dinhnd-hust/Octopus/v241218_Octopus_VerA1.kicad_pcb

## KiCad design v241218_Octopus_VerA1.kicad_pcb (2025-03-01)

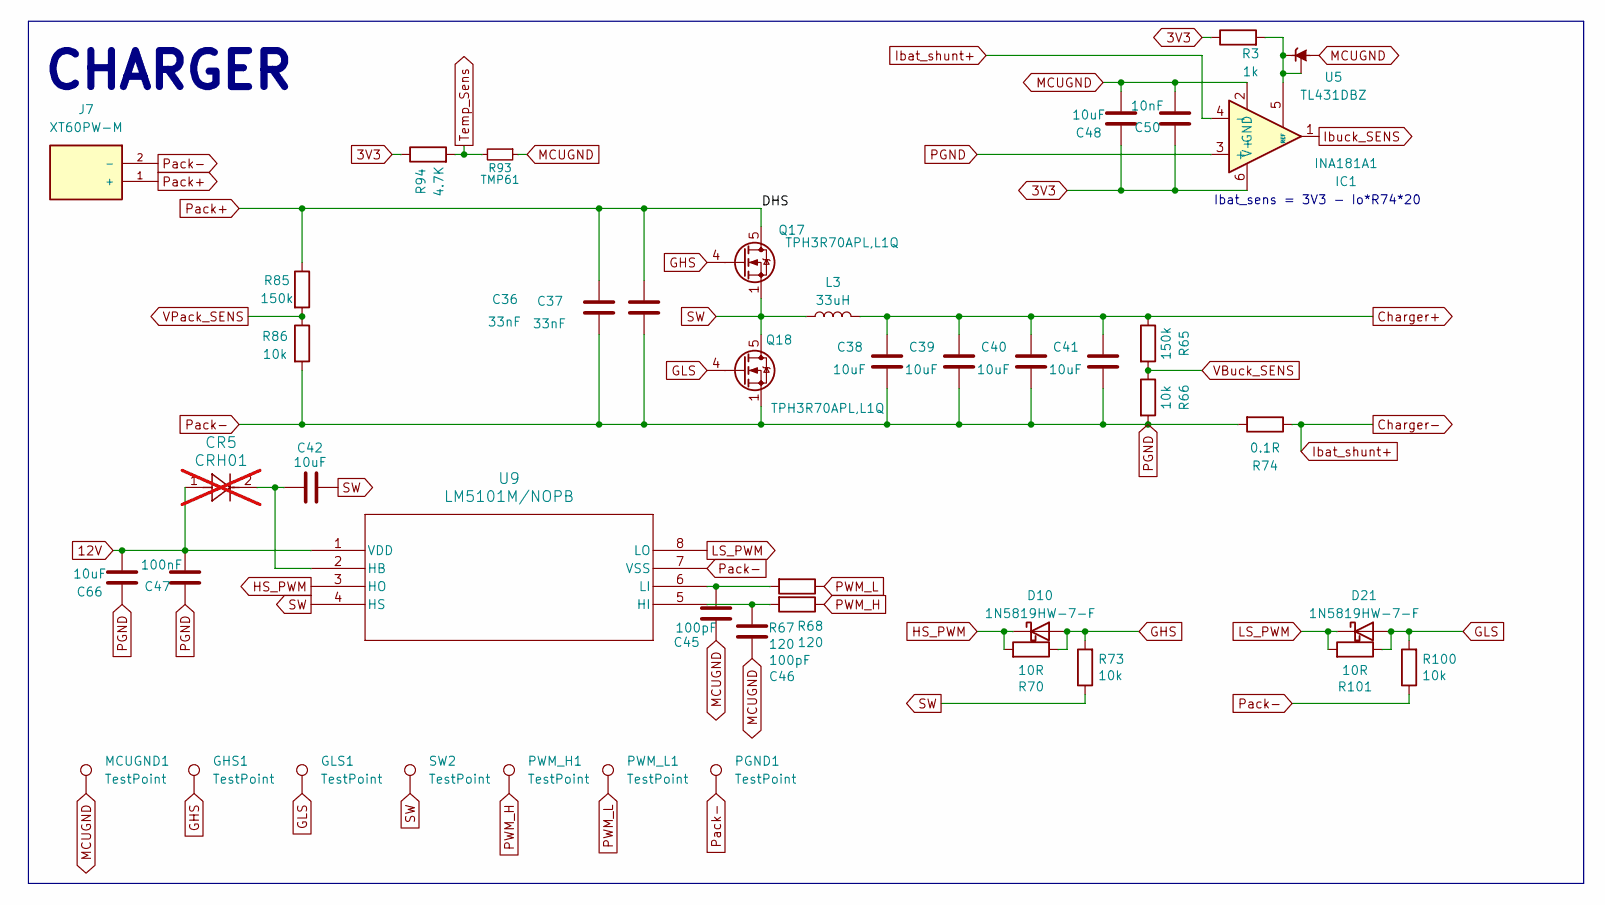
[picture p1: schematic Boost_Buck_Charger.kicad_sch]

Parts:
C36, C37: 33nF; C_1206_3216Metric; Mfr. # C1206B104K500NT
C38, C39, C40, C41, C42: 10uF; C_1206_3216Metric; Mfr. # C1206B104K500NT
C45, C46: 100pF; C_0603_1608Metric; Part Number KGQ15ACG1H101JT
C47: 100nF; C_0603_1608Metric; Part Number C0603C104M4RAC
C48, C66: 10uF; C_0603_1608Metric; Mfr. # MCF05KTX160106
C50: 10nF; C_0603_1608Metric; Part Number KAM15AR71H103MT
CR5: CRH01; S-FLAT_TOS; Part Number CRH01(TE85L,Q,M); not fitted
D10, D21: 1N5819HW-7-F; D_SOD-123; Part Number 1N5819HW-7-F
GHS1: TestPoint; TestPoint_Pad_D1.5mm
GLS1: TestPoint; TestPoint_Pad_D1.5mm
IC1: INA181A1; SOT-23-6; Mfr. # INA181A1IDBVR
J7: XT60PW-M; AMASS_XT60PW-M; PARTREV V1.2
L3: 33uH; L_Sunlord_MWSA1204S-2R2; Part Number SRR1280-330M
MCUGND1: TestPoint; TestPoint_Pad_D1.5mm
PGND1: TestPoint; TestPoint_Pad_D1.5mm
PWM_H1: TestPoint; TestPoint_Pad_D1.5mm
PWM_L1: TestPoint; TestPoint_Pad_D1.5mm
Q17, Q18: TPH3R70APL,L1Q; AO_DFN-8-1EP_5.55x5.2mm_P1.27mm_EP4.12x4.6mm; Part Number TPH3R70APL,L1Q
R3: 1k; R_0603_1608Metric; Mfr. # CR0805-FX-1003ELF
R65: 150k; R_0805_2012Metric; Mfr. # CR0805-FX-1003ELF
R66, R86: 10k; R_0805_2012Metric; Mfr. # CR0805-FX-1003ELF
R67, R68: 120; R_0603_1608Metric; Mfr. # CR0603-FX-1002ELF
R70, R101: 10R; R_0603_1608Metric; Part Number RS-05F10R0FT
R73, R100: 10k; R_0603_1608Metric; Part Number RS-03K1002FT
R74: 0.1R; R_2512_6332Metric; Part Number LR122WF100LT4E
R85: 150k; R_0805_2012Metric; Mfr. # CR0805-FX-1503ELF
R93: TMP61; R_0603_1608Metric; Mouser Part Number 595-TMP6131DECR
R94: 4.7K; R_0603_1608Metric; Mfr. # CR0805-FX-1003ELF
SW2: TestPoint; TestPoint_Pad_D1.5mm
U5: TL431DBZ; SOT-23; Part Number TL431BIDBZR
U9: LM5101M/NOPB; M08A; Part Number LM5101AM/NOPB

Connections:
3V3: C48.2, C50.2, IC1.6 (V+), R3.1, R94.1; also elsewhere on the board
12V: C47.1, C66.1, CR5.1, U9.1 (VDD); also elsewhere on the board
Charger+: C38.2, C39.2, C40.2, C41.2, L3.2, R65.1; also elsewhere on the board
Charger-: IC1.4 (-), R74.1; also elsewhere on the board
GHS: D10.2 (A), GHS1.1, Q17.4 (G), R70.1, R73.2
GLS: D21.2 (A), GLS1.1, Q18.4 (G), R100.2, R101.1
HS_PWM: D10.1 (K), R70.2, U9.3 (HO)
Ibuck_SENS: IC1.1; also elsewhere on the board
LS_PWM: D21.1 (K), R101.2, U9.8 (LO)
MCUGND: C45.2, C46.2, C48.1, C50.1, IC1.2 (GND), MCUGND1.1, R93.1, U5.3 (A); also elsewhere on the board
unnamed: IC1.5 (REF), R3.2, U5.1 (K), U5.2 (REF)
unnamed: C42.2, CR5.2, U9.2 (HB)
unnamed: C46.1, R68.2, U9.5 (HI)
unnamed: C45.1, R67.2, U9.6 (LI)
PGND: C36.1, C37.1, C38.1, C39.1, C40.1, C41.1, C47.2, C66.2, IC1.3 (+), J7.2 (-), PGND1.1, Q18.1 (S), Q18.2 (S), Q18.3 (S), R66.2, R74.2, R86.2, R100.1, U9.7 (VSS); also elsewhere on the board
PWM_H: PWM_H1.1, R68.1; also elsewhere on the board
PWM_L: PWM_L1.1, R67.1; also elsewhere on the board
Pack+: C36.2, C37.2, J7.1 (+), Q17.5 (D), R85.1; also elsewhere on the board
SW: C42.1, L3.1, Q17.1 (S), Q17.2 (S), Q17.3 (S), Q18.5 (D), R73.1, SW2.1, U9.4 (HS)
Temp_Sens: R93.2, R94.2; also elsewhere on the board
VBuck_SENS: R65.2, R66.1; also elsewhere on the board
VPack_SENS: R85.2, R86.1; also elsewhere on the board

Notes on the sheet:
Ibat_sens = 3V3 - Io*R74*20
CHARGER

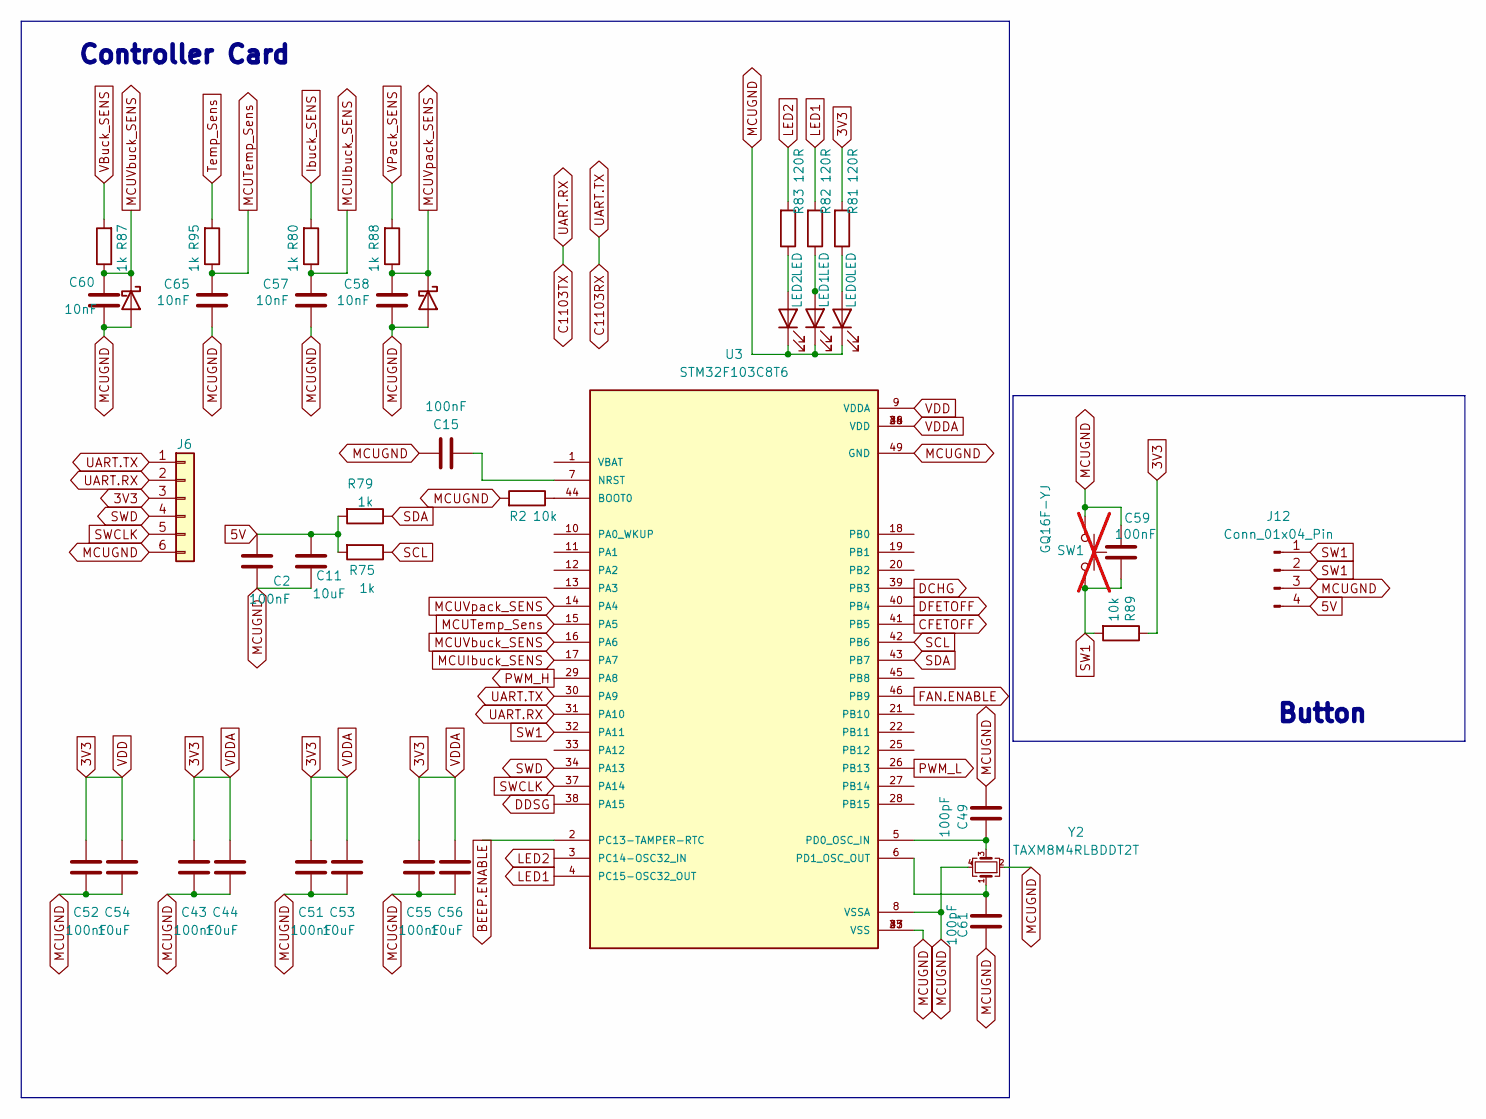
[picture p2: schematic MCU.kicad_sch]

Parts:
C2: 100nF; C_0603_1608Metric; Mfr. # MCF05KTX160106
C11: 10uF; C_0603_1608Metric; Mfr. # C2012B104K500NT
C15, C43, C51, C52, C55, C59: 100nF; C_0603_1608Metric; Mfr. # C2012B104K500NT
C44, C53, C54, C56: 10uF; C_0603_1608Metric; Mfr. # MCF05KTX160106
C49, C61: 100pF; C_0603_1608Metric; Mfr. # C2012B104K500NT
C57, C58, C65: 10nF; C_0603_1608Metric; Mfr. # C2012N102J100NT
C60: 10nF; C_0603_1608Metric; Mfr. # C2012N103J100NT
D3, D7: 1N4148; D_SOD-123; Mfr. # 1N4148W
J6: Conn_01x06; Molex_KK-254_AE-6410-06A_1x06_P2.54mm_Vertical; Part Number 22272061
J12: Conn_01x04_Pin; Molex_KK-254_AE-6410-04A_1x04_P2.54mm_Vertical; Part Number 22272041
LED0: LED; LED_0603_1608Metric; Mfr. # Red LED
LED1, LED2: LED; LED_0603_1608Metric; Mfr. # Green LED
R2: 10k; R_0603_1608Metric; Mfr. # CR0805-FX-1001ELF
R75, R79: 1k; R_0603_1608Metric; Mfr. # CR0603-FX-1002ELF
R80, R87, R88, R95: 1k; R_0603_1608Metric; Mfr. # CR0805-FX-1001ELF
R81, R82, R83: 120R; R_0603_1608Metric; Mfr. # CR0805-FX-120R0ELF
R89: 10k; R_0603_1608Metric; Mfr. # CR0603-FX-1002ELF
SW1: GQ16F-YJ; SW_PUSH_6mm; Part Number GQ16F-YJ; not fitted
U3: STM32F103C8T6; LQFP-48-1EP_7x7mm_P0.5mm_EP3.6x3.6mm_ThermalVias; PARTREV 10
Y2: TAXM8M4RLBDDT2T; Crystal_SMD_3225-4Pin_3.2x2.5mm; Part Number TAXM8M4RLBDDT2T

Connections:
3V3: C43.2, C44.1, C51.2, C52.2, C53.1, C54.1, C55.2, C56.1, J6.3, R81.2, R89.1, U3.9 (VDDA), U3.24 (VDD), U3.36 (VDD), U3.48 (VDD); also elsewhere on the board
5V: C2.1, C11.2, J12.4, R75.2, R79.2; also elsewhere on the board
BEEP.ENABLE: U3.2 (PC13-TAMPER-RTC); also elsewhere on the board
C1103RX: J6.1, U3.30 (PA9); also elsewhere on the board
C1103TX: J6.2, U3.31 (PA10); also elsewhere on the board
CFETOFF: U3.41 (PB5); also elsewhere on the board
DCHG: U3.39 (PB3); also elsewhere on the board
DDSG: U3.38 (PA15); also elsewhere on the board
DFETOFF: U3.40 (PB4); also elsewhere on the board
FAN.ENABLE: U3.46 (PB9); also elsewhere on the board
Ibuck_SENS: R80.2; also elsewhere on the board
LED1: R82.2, U3.4 (PC15-OSC32_OUT)
LED2: R83.2, U3.3 (PC14-OSC32_IN)
MCUGND: C2.2, C11.1, C15.1, C43.1, C44.2, C49.2, C51.1, C52.1, C53.2, C54.2, C55.1, C56.2, C57.1, C58.1, C59.2, C60.1, C61.1, C65.1, D3.2 (A), D7.2 (A), J6.6, J12.3, LED0.1 (K), LED1.1 (K), LED2.1 (K), R2.2, SW1.1, U3.8 (VSSA), U3.23 (VSS), U3.35 (VSS), U3.47 (VSS), U3.49 (GND), Y2.2, Y2.4; also elsewhere on the board
MCUIbuck_SENS: C57.2, R80.1, U3.17 (PA7)
MCUTemp_Sens: C65.2, R95.1, U3.15 (PA5)
MCUVbuck_SENS: C60.2, D7.1 (K), R87.1, U3.16 (PA6)
MCUVpack_SENS: C58.2, D3.1 (K), R88.1, U3.14 (PA4)
unnamed: LED0.2 (A), R81.1
unnamed: LED1.2 (A), R82.1
unnamed: LED2.2 (A), R83.1
unnamed: R2.1, U3.44 (BOOT0)
unnamed: C15.2, U3.7 (NRST)
unnamed: C49.1, U3.5 (PD0_OSC_IN), Y2.3
unnamed: C61.2, U3.6 (PD1_OSC_OUT), Y2.1
PWM_H: U3.29 (PA8); also elsewhere on the board
PWM_L: U3.26 (PB13); also elsewhere on the board
SCL: R75.1, U3.42 (PB6); also elsewhere on the board
SDA: R79.1, U3.43 (PB7); also elsewhere on the board
SW1: C59.1, J12.1, J12.2, R89.2, SW1.2, U3.32 (PA11)
SWCLK: J6.5, U3.37 (PA14)
SWD: J6.4, U3.34 (PA13)
Temp_Sens: R95.2; also elsewhere on the board
VBuck_SENS: R87.2; also elsewhere on the board
VPack_SENS: R88.2; also elsewhere on the board

Notes on the sheet:
Button
Controller Card

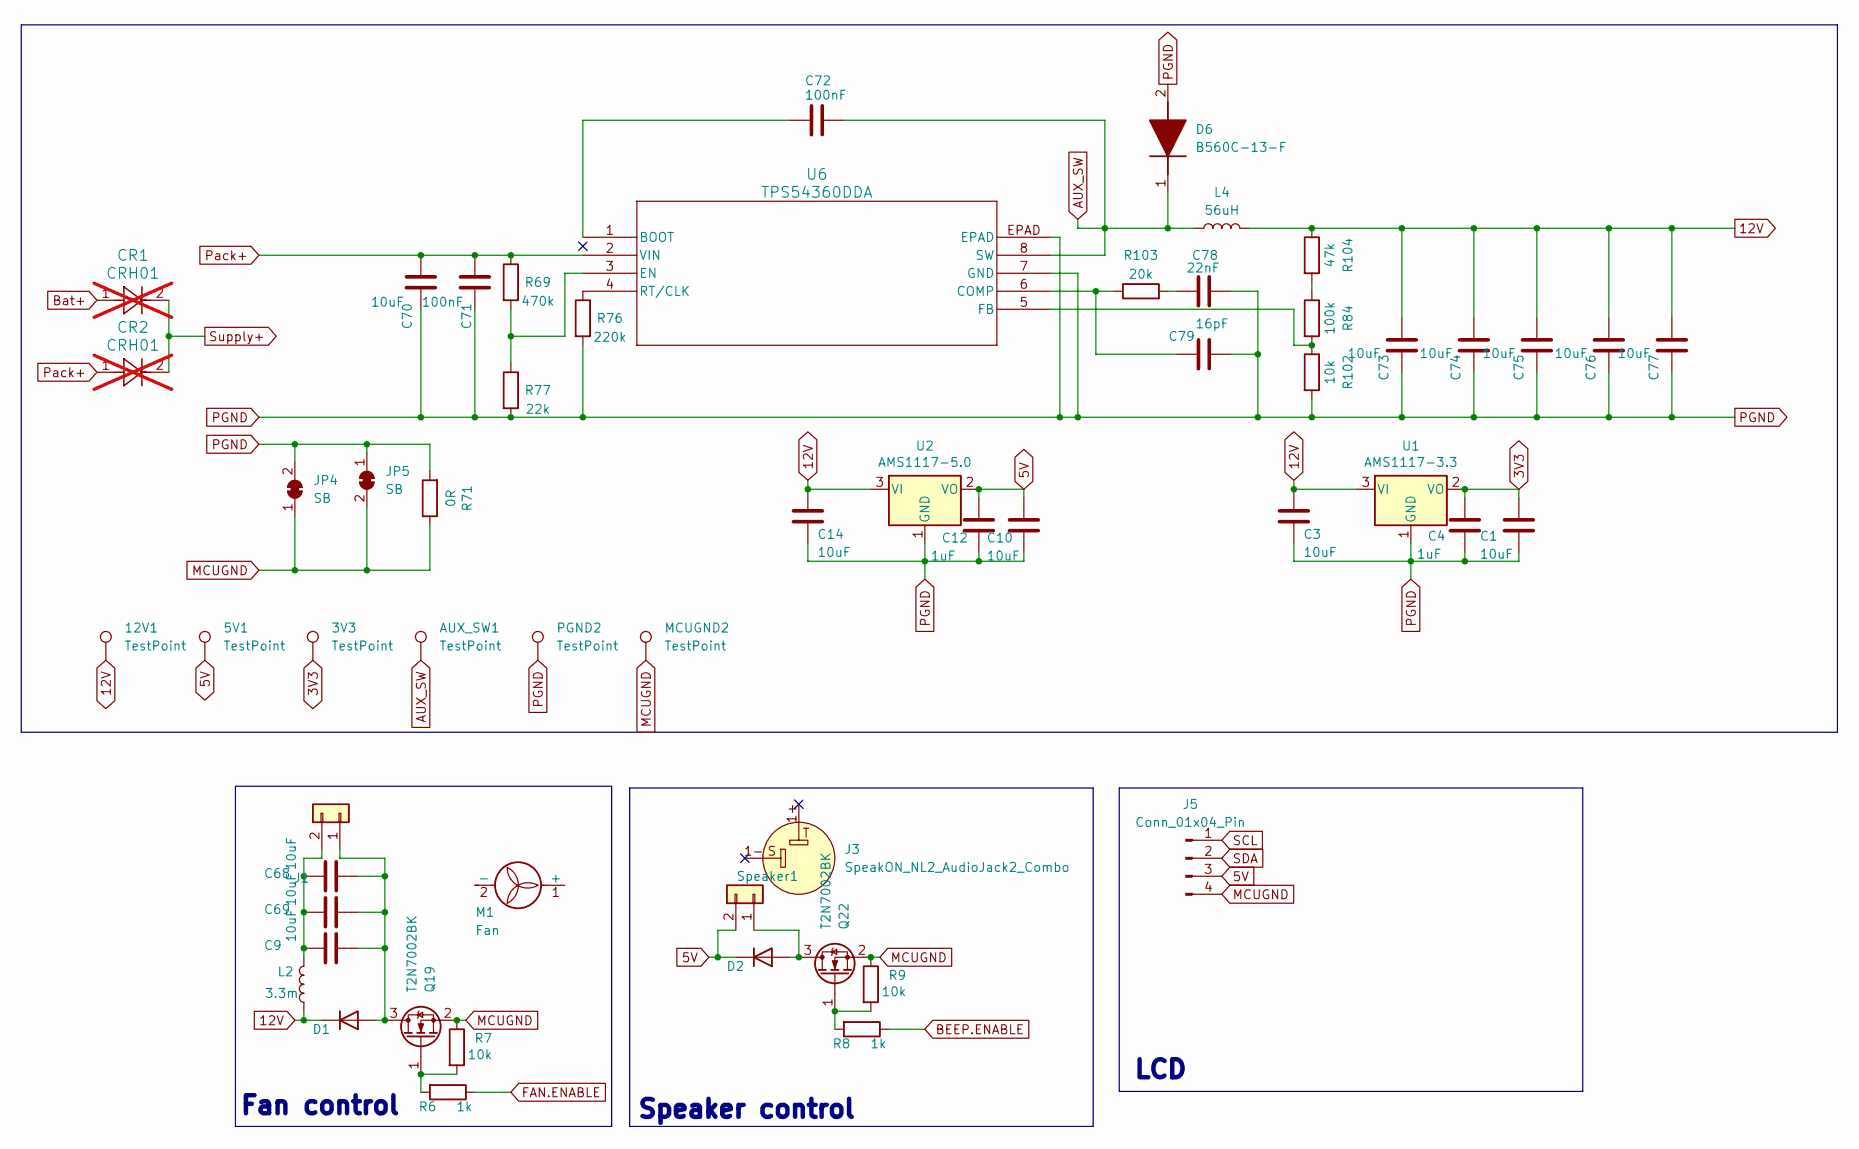
[picture p3: schematic Buck_AuxSupply.kicad_sch]

Parts:
3V3, 5V1, 12V1: TestPoint; TestPoint_Pad_D1.5mm
AUX_SW1: TestPoint; TestPoint_Pad_D1.5mm
C1, C3, C10, C14: 10uF; C_0805_2012Metric; Mfr. # MCF05KTX160106
C4, C12: 1uF; C_0805_2012Metric; Mfr. # C2012B104K500NT
C9, C68, C69, C70, C73, C74, C75, C76, C77: 10uF; C_0805_2012Metric; Mfr. # C2012B104K500NT
C71, C72: 100nF; C_0805_2012Metric; Mfr. # C2012B104K500NT
C78: 22nF; C_0805_2012Metric; Mfr. # C2012B104K500NT
C79: 16pF; C_0805_2012Metric; Mfr. # C2012B104K500NT
CR1, CR2: CRH01; S-FLAT_TOS; Part Number CRH01(TE85L,Q,M); not fitted
D1, D2: 1N4148; D_SOD-123; Mfr. # 1N4148W
D6: B560C-13-F; DIOM7959X250N; Mouser Part Number 621-B560C-F
J1: Conn_FAN; Molex_KK-254_AE-6410-02A_1x02_P2.54mm_Vertical; Part Number 0022272021
J3: SpeakON_NL2_AudioJack2_Combo; Part Number TMB12A05
J5: Conn_01x04_Pin; Molex_KK-254_AE-6410-04A_1x04_P2.54mm_Vertical; Part Number 22272041
JP4, JP5: SB; SolderJumper-2_P1.3mm_Bridged2Bar_RoundedPad1.0x1.5mm
L2: 3.3m; L_Axial_L9.5mm_D4.0mm_P2.54mm_Vertical_Fastron_SMCC; Part Number AL0510-332K
L4: 56uH; L_Sunlord_MWSA0804S; Part Number SRR1280-560M
M1: Fan; Fan40x40x20; Mfr. # Fan
MCUGND2: TestPoint; TestPoint_Pad_D1.5mm
PGND2: TestPoint; TestPoint_Pad_D1.5mm
Q19, Q22: T2N7002BK; SOT-23; Part Number T2N7002BK
R6, R8: 1k; R_0603_1608Metric; Mfr. # CR0805-FX-1001ELF
R7, R9: 10k; R_0603_1608Metric; Mfr. # CR0805-FX-1002ELF
R69: 470k; R_0805_2012Metric; Mfr. # CR0805-FX-1004ELF
R71: 0R; R_0603_1608Metric; Part Number RC0603FR-100RL
R76: 220k; R_0805_2012Metric; Mfr. # CR0805-FX-1004ELF
R77: 22k; R_0805_2012Metric; Mfr. # CR0805-FX-1004ELF
R84: 100k; R_0805_2012Metric; Mfr. # CR0805-FX-1003ELF
R102: 10k; R_0805_2012Metric; Mfr. # CR0805-FX-1003ELF
R103: 20k; R_0805_2012Metric; Mfr. # CR0805-FX-1004ELF
R104: 47k; R_0805_2012Metric; Mfr. # CR0805-FX-1003ELF
Speaker1: TMB12A05; MagneticBuzzer_ProSignal_ABI-010-RC; Part Number TMB12A05
U1: AMS1117-3.3; SOT-223-3_TabPin2; Mfr. # TLV1117LV33DCYR
U2: AMS1117-5.0; SOT-223-3_TabPin2; Mfr. # AMS1117-5.0
U6: TPS54360DDA; DDA8_3P1X2P4_TEX-L; Part Number TPS54360DDA

Connections:
3V3: 3V3.1, C1.1, C4.2, U1.2 (VO); also elsewhere on the board
5V: 5V1.1, C10.1, C12.2, D2.1 (K), J5.3, Speaker1.2, U2.2 (VO); also elsewhere on the board
12V: 12V1.1, C3.1, C14.1, C73.2, C74.2, C75.2, C76.2, C77.2, D1.1 (K), L2.1, L4.2, R104.1, U1.3 (VI), U2.3 (VI); also elsewhere on the board
AUX_SW: AUX_SW1.1, C72.2, D6.1 (K), L4.1, U6.8 (SW)
BEEP.ENABLE: R8.1; also elsewhere on the board
FAN.ENABLE: R6.1; also elsewhere on the board
MCUGND: J5.4, JP4.1 (A), JP5.2 (B), MCUGND2.1, Q19.2 (S), Q22.2 (S), R7.1, R9.1, R71.1; also elsewhere on the board
unnamed: C78.1, R103.2
unnamed: CR1.2, CR2.2
unnamed: C9.2, C68.2, C69.2, D1.2 (A), J1.1, Q19.3 (D)
unnamed: D2.2 (A), Q22.3 (D), Speaker1.1
unnamed: C9.1, C68.1, C69.1, J1.2, L2.2
unnamed: Q19.1 (G), R6.2, R7.2
unnamed: Q22.1 (G), R8.2, R9.2
unnamed: R84.1, R104.2
unnamed: C72.1, U6.1 (BOOT)
unnamed: C79.1, R103.1, U6.6 (COMP)
unnamed: R69.2, R77.1, U6.3 (EN)
unnamed: R84.2, R102.1, U6.5 (FB)
unnamed: R76.1, U6.4 (RT/CLK)
PGND: C1.2, C3.2, C4.1, C10.2, C12.1, C14.2, C70.1, C71.1, C73.1, C74.1, C75.1, C76.1, C77.1, C78.2, C79.2, D6.2 (A), JP4.2 (B), JP5.1 (A), PGND2.1, R71.2, R76.2, R77.2, R102.2, U1.1 (GND), U2.1 (GND), U6.7 (GND), U6.EPAD; also elsewhere on the board
Pack+: C70.2, C71.2, CR2.1, R69.1, U6.2 (VIN); also elsewhere on the board
SCL: J5.1; also elsewhere on the board
SDA: J5.2; also elsewhere on the board

Notes on the sheet:
Fan control
Speaker control
LCD

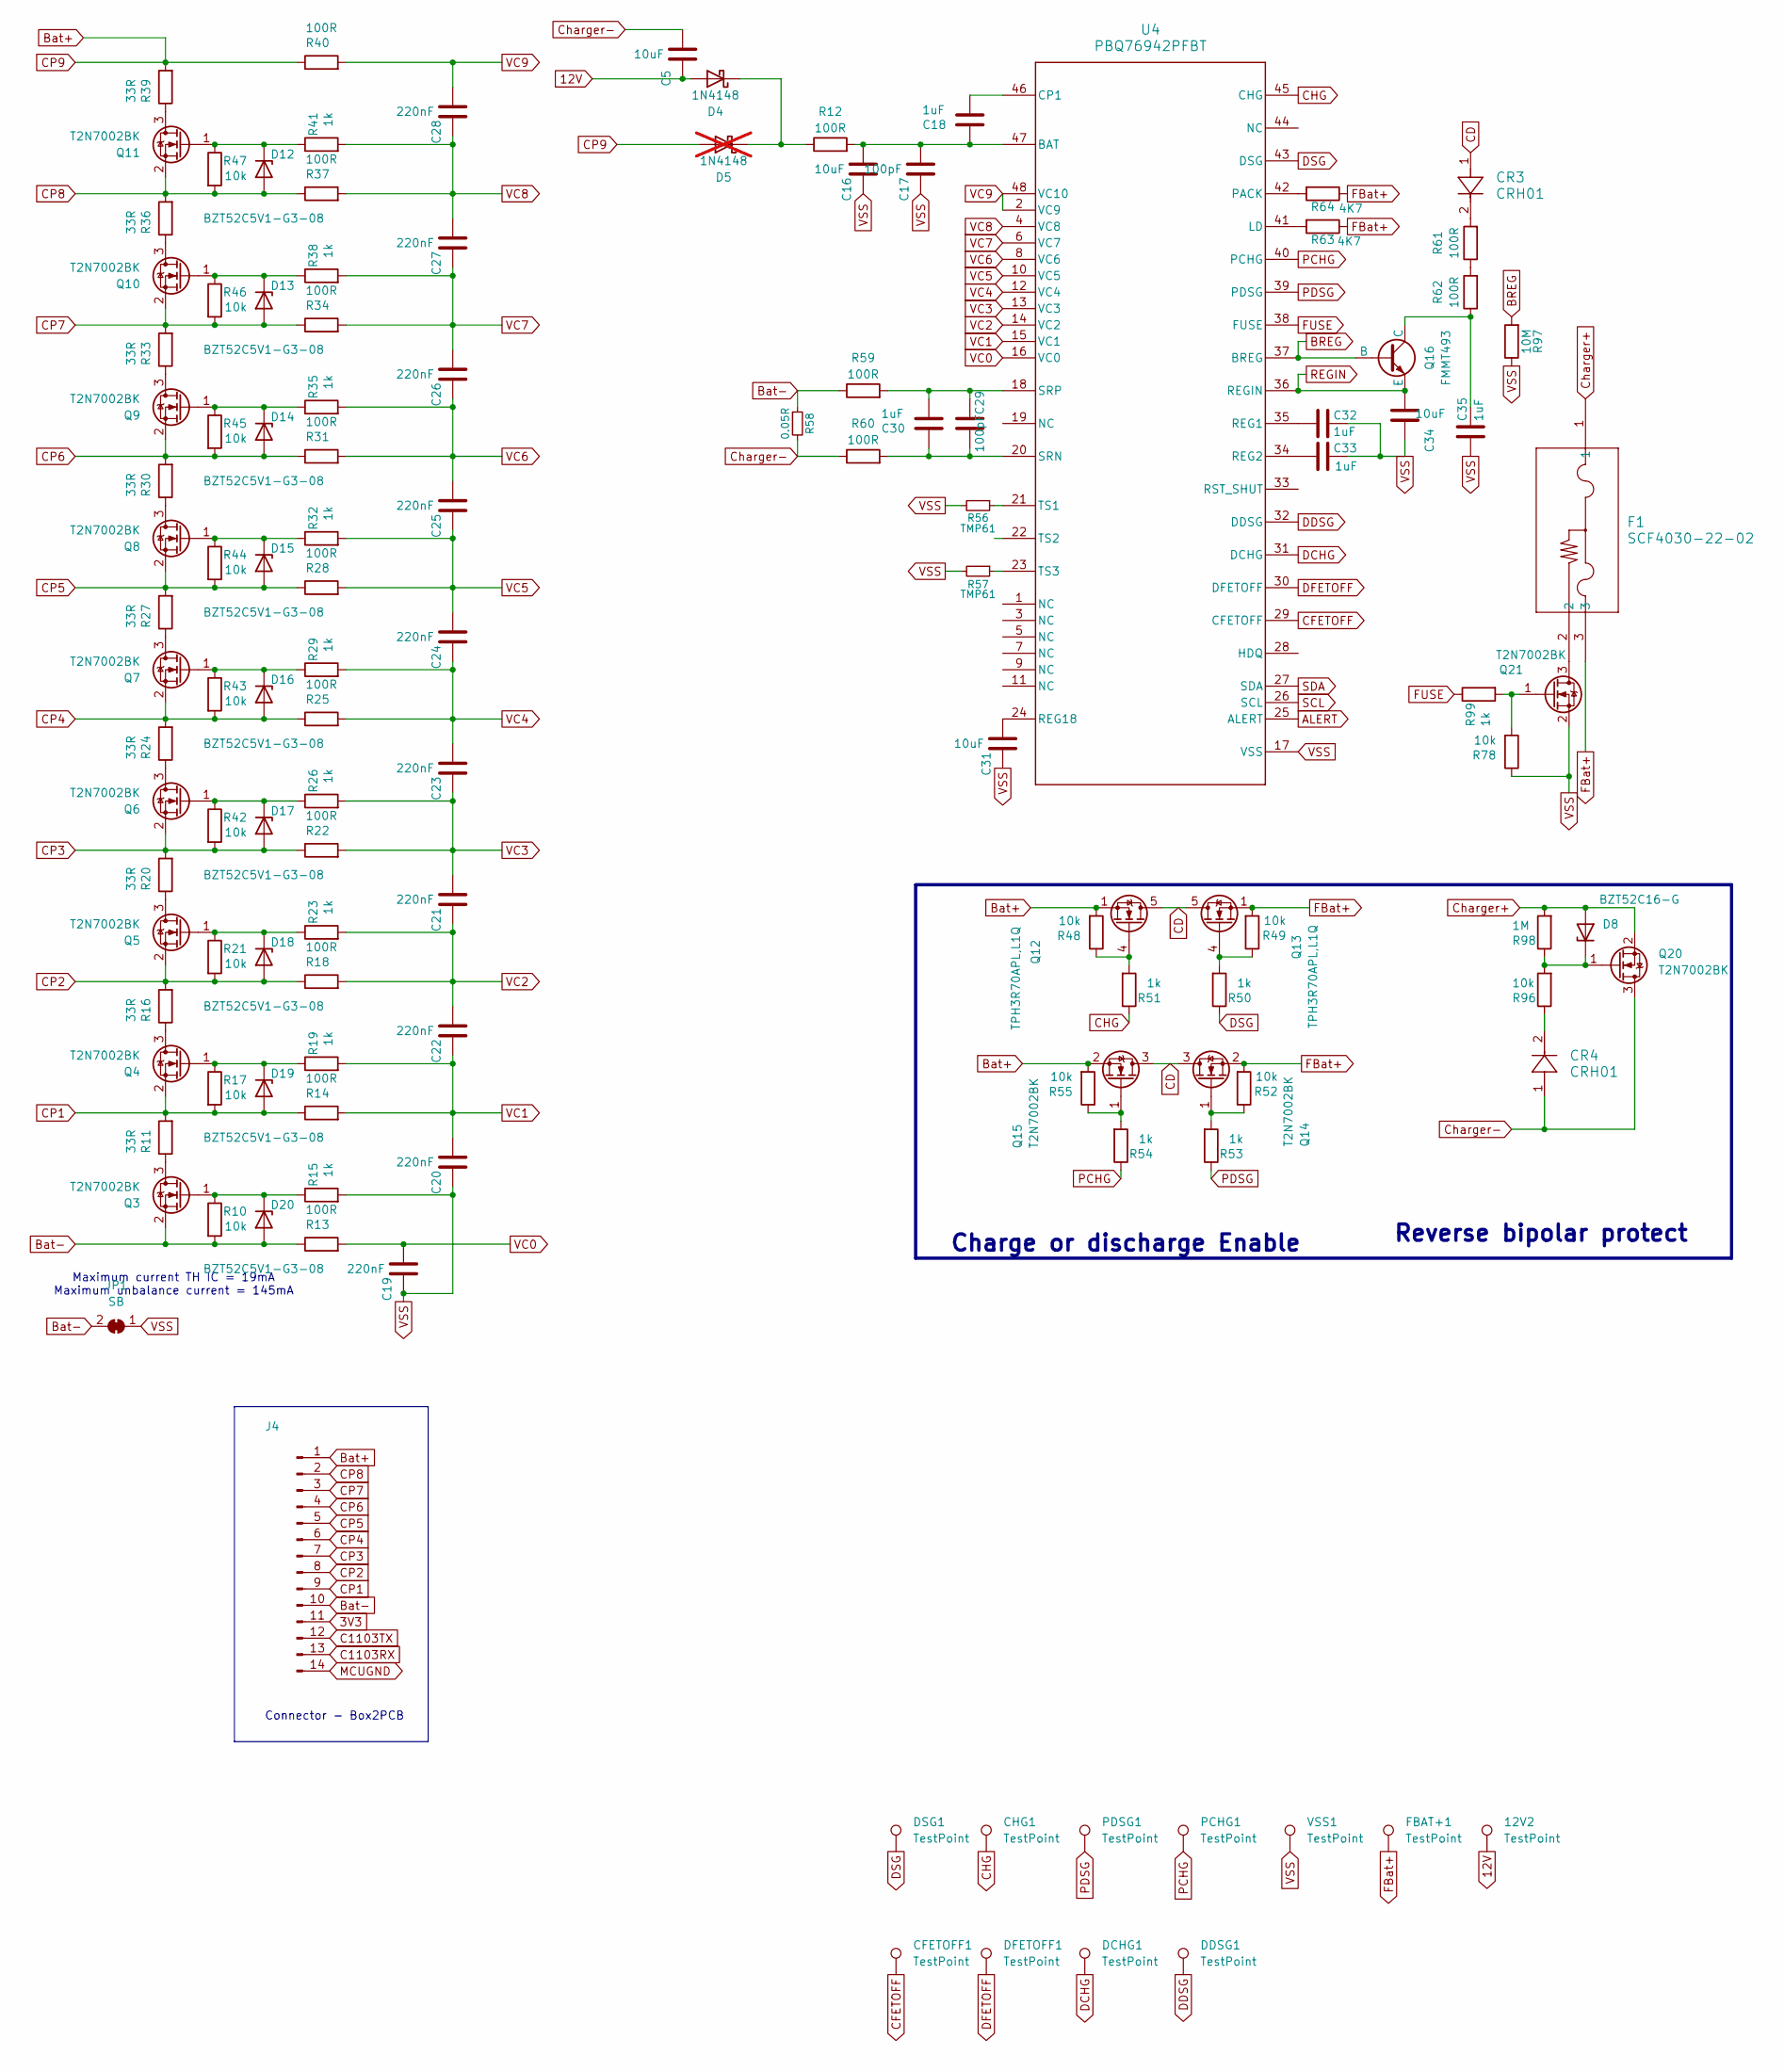
[picture p4: schematic BMS.kicad_sch]

Parts:
12V2: TestPoint; TestPoint_Pad_D1.5mm
C5, C16, C34: 10uF; C_0805_2012Metric; Mfr. # C2012B104K500NT
C17, C29: 100pF; C_0603_1608Metric; Mfr. # C2012B104K500NT
C18, C30, C32, C33, C35: 1uF; C_0603_1608Metric; Mfr. # C2012B104K500NT
C19, C20, C21, C22, C23, C24, C25, C26, C27, C28: 220nF; C_0603_1608Metric; Mfr. # C2012B104K500NT
C31: 10uF; C_0603_1608Metric; Mfr. # C2012B104K500NT
CFETOFF1: TestPoint; TestPoint_Pad_D1.5mm
CHG1: TestPoint; TestPoint_Pad_D1.5mm
CR3, CR4: CRH01; S-FLAT_TOS; Part Number CRH01(TE85L,Q,M)
D4: 1N4148; D_SOD-123; Mfr. # 1N4148W
D5: 1N4148; D_SOD-123; Mfr. # 1N4148W; not fitted
D8: BZT52C16-G; D_SOD-123; Part Number BZT52C16-G
D12, D13, D14, D15, D16, D17, D18, D19, D20: BZT52C5V1-G3-08; D_SOD-123; Part Number BZT52C5V1-G3-08
DCHG1: TestPoint; TestPoint_Pad_D1.5mm
DDSG1: TestPoint; TestPoint_Pad_D1.5mm
DFETOFF1: TestPoint; TestPoint_Pad_D1.5mm
DSG1: TestPoint; TestPoint_Pad_D1.5mm
F1: SCF4030-22-02; ITV4030L1212NR_LTF; Part Number SCF4030-22-02
FBAT+1: TestPoint; TestPoint_Pad_D1.5mm
J4: Connector_Bat; Molex_KK-254_AE-6410-14A_1x14_P2.54mm_Vertical; Part Number 22272141
JP1: SB; SolderJumper-2_P1.3mm_Bridged2Bar_RoundedPad1.0x1.5mm
PCHG1: TestPoint; TestPoint_Pad_D1.5mm
PDSG1: TestPoint; TestPoint_Pad_D1.5mm
Q3, Q4, Q5, Q6, Q7, Q8, Q9, Q10, Q11, Q14, Q15, Q20, Q21: T2N7002BK; SOT-23; Part Number T2N7002BK
Q12, Q13: TPH3R70APL,L1Q; AO_DFN-8-1EP_5.55x5.2mm_P1.27mm_EP4.12x4.6mm; Part Number TPH3R70APL,L1Q
Q16: FMMT493; SOT-23; Part Number FMMT493TA
R10, R17, R21, R42, R43, R44, R45, R46, R47, R48, R49, R52, R55, R78, R96: 10k; R_0603_1608Metric; Mfr. # CR0603-FX-1002ELF
R11, R16, R20, R24, R27, R30, R33, R36, R39: 33R; R_0805_2012Metric; Mfr. # CR0805-FX-1002ELF
R12, R59, R60, R61, R62: 100R; R_0603_1608Metric; Mfr. # CR0805-FX-1003ELF
R13, R14, R18, R22, R25, R28, R31, R34, R37, R40: 100R; R_0603_1608Metric; Mfr. # CR0805-FX-1002ELF
R15, R19, R23, R26, R29, R32, R35, R38, R41, R50, R51, R53, R54, R99: 1k; R_0603_1608Metric; Mfr. # CR0603-FX-1002ELF
R56, R57: TMP61; R_0603_1608Metric; Mouser Part Number 595-TMP6131DECR
R58: 0.05R; R_1210_3225Metric; Part Number ERJ-L14KF50MU
R63, R64: 4K7; R_0603_1608Metric; Mfr. # CR0603-FX-1003ELF
R97: 10M; R_0603_1608Metric; Mfr. # CR0603-FX-1003ELF
R98: 1M; R_0603_1608Metric; Mfr. # CR0603-FX-1002ELF
U4: PBQ76942PFBT; PFB0048A_L; Part Number BQ76942PFBR
VSS1: TestPoint; TestPoint_Pad_D1.5mm

Connections:
3V3: J4.11; also elsewhere on the board
12V: 12V2.1, C5.1, D4.2 (A); also elsewhere on the board
ALERT: U4.25 (ALERT)
BREG: Q16.2 (B), R97.2, U4.37 (BREG)
Bat+: D5.2 (A), J4.1, Q12.1 (S), Q12.2 (S), Q12.3 (S), Q15.2 (S), R39.2, R40.1, R48.2, R55.2
Bat-: D20.2 (A), J4.10, JP1.2 (B), Q3.2 (S), R10.2, R13.1, R58.1, R59.1
C1103RX: J4.13; also elsewhere on the board
C1103TX: J4.12; also elsewhere on the board
CD: CR3.1, Q12.5 (D), Q13.5 (D), Q14.3 (D), Q15.3 (D)
CFETOFF: CFETOFF1.1, U4.29 (CFETOFF); also elsewhere on the board
CHG: CHG1.1, R51.1, U4.45 (CHG)
CP1: D19.2 (A), J4.9, Q4.2 (S), R11.2, R14.1, R17.2
CP2: D18.2 (A), J4.8, Q5.2 (S), R16.2, R18.1, R21.2
CP3: D17.2 (A), J4.7, Q6.2 (S), R20.2, R22.1, R42.2
CP4: D16.2 (A), J4.6, Q7.2 (S), R24.2, R25.1, R43.2
CP5: D15.2 (A), J4.5, Q8.2 (S), R27.2, R28.1, R44.2
CP6: D14.2 (A), J4.4, Q9.2 (S), R30.2, R31.1, R45.2
CP7: D13.2 (A), J4.3, Q10.2 (S), R33.2, R34.1, R46.2
CP8: D12.2 (A), J4.2, Q11.2 (S), R36.2, R37.1, R47.2
Charger+: D8.2 (A), F1.1, Q20.2 (S), R98.2; also elsewhere on the board
Charger-: C5.2, CR4.1, Q20.3 (D), R58.2, R60.1; also elsewhere on the board
DCHG: DCHG1.1, U4.31 (DCHG); also elsewhere on the board
DDSG: DDSG1.1, U4.32 (DDSG); also elsewhere on the board
DFETOFF: DFETOFF1.1, U4.30 (DFETOFF); also elsewhere on the board
DSG: DSG1.1, R50.1, U4.43 (DSG)
FBat+: F1.3, FBAT+1.1, Q13.1 (S), Q13.2 (S), Q13.3 (S), Q14.2 (S), R49.2, R52.2, R63.1, R64.1
FUSE: R99.1, U4.38 (FUSE)
MCUGND: J4.14; also elsewhere on the board
unnamed: CR3.2, R61.2
unnamed: CR4.2, R96.1
unnamed: D4.1 (K), D5.1 (K), R12.1
unnamed: D8.1 (K), Q20.1 (G), R96.2, R98.1
unnamed: D12.1 (K), Q11.1 (G), R41.1, R47.1
unnamed: D13.1 (K), Q10.1 (G), R38.1, R46.1
unnamed: D14.1 (K), Q9.1 (G), R35.1, R45.1
unnamed: D15.1 (K), Q8.1 (G), R32.1, R44.1
unnamed: D16.1 (K), Q7.1 (G), R29.1, R43.1
unnamed: D17.1 (K), Q6.1 (G), R26.1, R42.1
unnamed: D18.1 (K), Q5.1 (G), R21.1, R23.1
unnamed: D19.1 (K), Q4.1 (G), R17.1, R19.1
unnamed: D20.1 (K), Q3.1 (G), R10.1, R15.1
unnamed: Q3.3 (D), R11.1
unnamed: Q4.3 (D), R16.1
unnamed: Q5.3 (D), R20.1
unnamed: Q6.3 (D), R24.1
unnamed: Q7.3 (D), R27.1
unnamed: Q8.3 (D), R30.1
unnamed: Q9.3 (D), R33.1
unnamed: Q10.3 (D), R36.1
unnamed: Q11.3 (D), R39.1
unnamed: Q12.4 (G), R48.1, R51.2
unnamed: Q13.4 (G), R49.1, R50.2
unnamed: Q14.1 (G), R52.1, R53.2
unnamed: Q15.1 (G), R54.2, R55.1
unnamed: C35.2, Q16.1 (C), R62.1
unnamed: F1.2, Q21.3 (D)
unnamed: Q21.1 (G), R78.2, R99.2
unnamed: R61.1, R62.2
unnamed: C16.2, C17.2, C18.1, R12.2, U4.47 (BAT)
unnamed: C18.2, U4.46 (CP1)
unnamed: R63.2, U4.41 (LD)
unnamed: R64.2, U4.42 (PACK)
unnamed: C32.1, U4.35 (REG1)
unnamed: C33.1, U4.34 (REG2)
unnamed: C31.2, U4.24 (REG18)
unnamed: C29.1, C30.1, R60.2, U4.20 (SRN)
unnamed: C29.2, C30.2, R59.2, U4.18 (SRP)
unnamed: R56.1, U4.21 (TS1)
unnamed: R57.1, U4.23 (TS3)
PCHG: PCHG1.1, R54.1, U4.40 (PCHG)
PDSG: PDSG1.1, R53.1, U4.39 (PDSG)
REGIN: C34.2, Q16.3 (E), U4.36 (REGIN)
SCL: U4.26 (SCL); also elsewhere on the board
SDA: U4.27 (SDA); also elsewhere on the board
VC0: C19.2, R13.2, U4.16 (VC0)
VC1: C20.2, C22.1, R14.2, R19.2, U4.15 (VC1)
VC2: C21.1, C22.2, R18.2, R23.2, U4.14 (VC2)
VC3: C21.2, C23.1, R22.2, R26.2, U4.13 (VC3)
VC4: C23.2, C24.1, R25.2, R29.2, U4.12 (VC4)
VC5: C24.2, C25.1, R28.2, R32.2, U4.10 (VC5)
VC6: C25.2, C26.1, R31.2, R35.2, U4.8 (VC6)
VC7: C26.2, C27.1, R34.2, R38.2, U4.6 (VC7)
VC8: C27.2, C28.1, R37.2, R41.2, U4.4 (VC8)
VC9: C28.2, R40.2, U4.2 (VC9), U4.48 (VC10)
VSS: C16.1, C17.1, C19.1, C20.1, C31.1, C32.2, C33.2, C34.1, C35.1, JP1.1 (A), Q21.2 (S), R15.2, R56.2, R57.2, R78.1, R97.1, U4.17 (VSS), VSS1.1

Notes on the sheet:
Connector - Box2PCB
Reverse bipolar protect
Charge or discharge Enable
Maximum current TH IC = 19mA Maximum unbalance current = 145mA

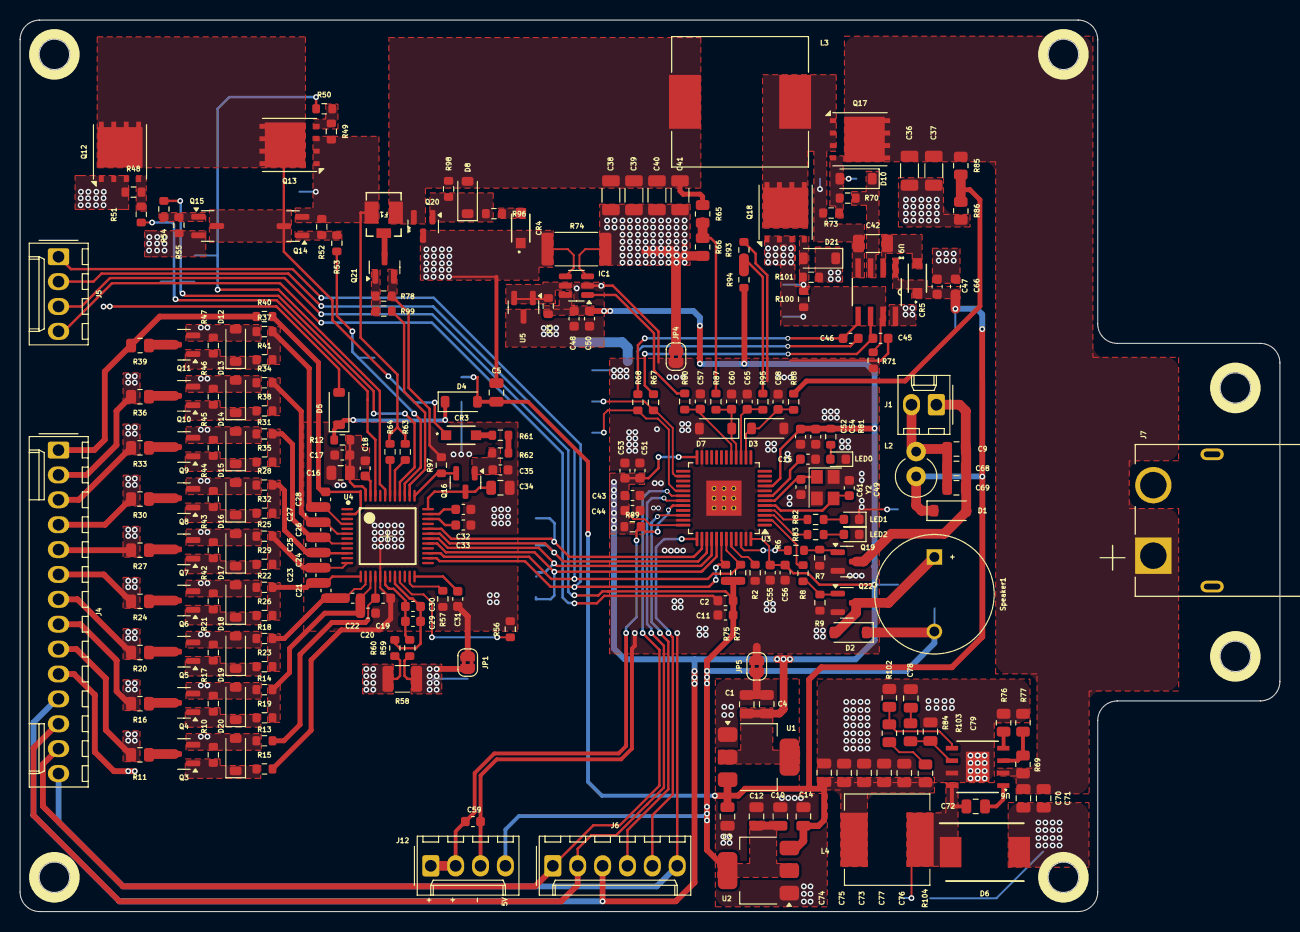
[picture p5: board v241218_Octopus_VerA1.kicad_pcb from above]

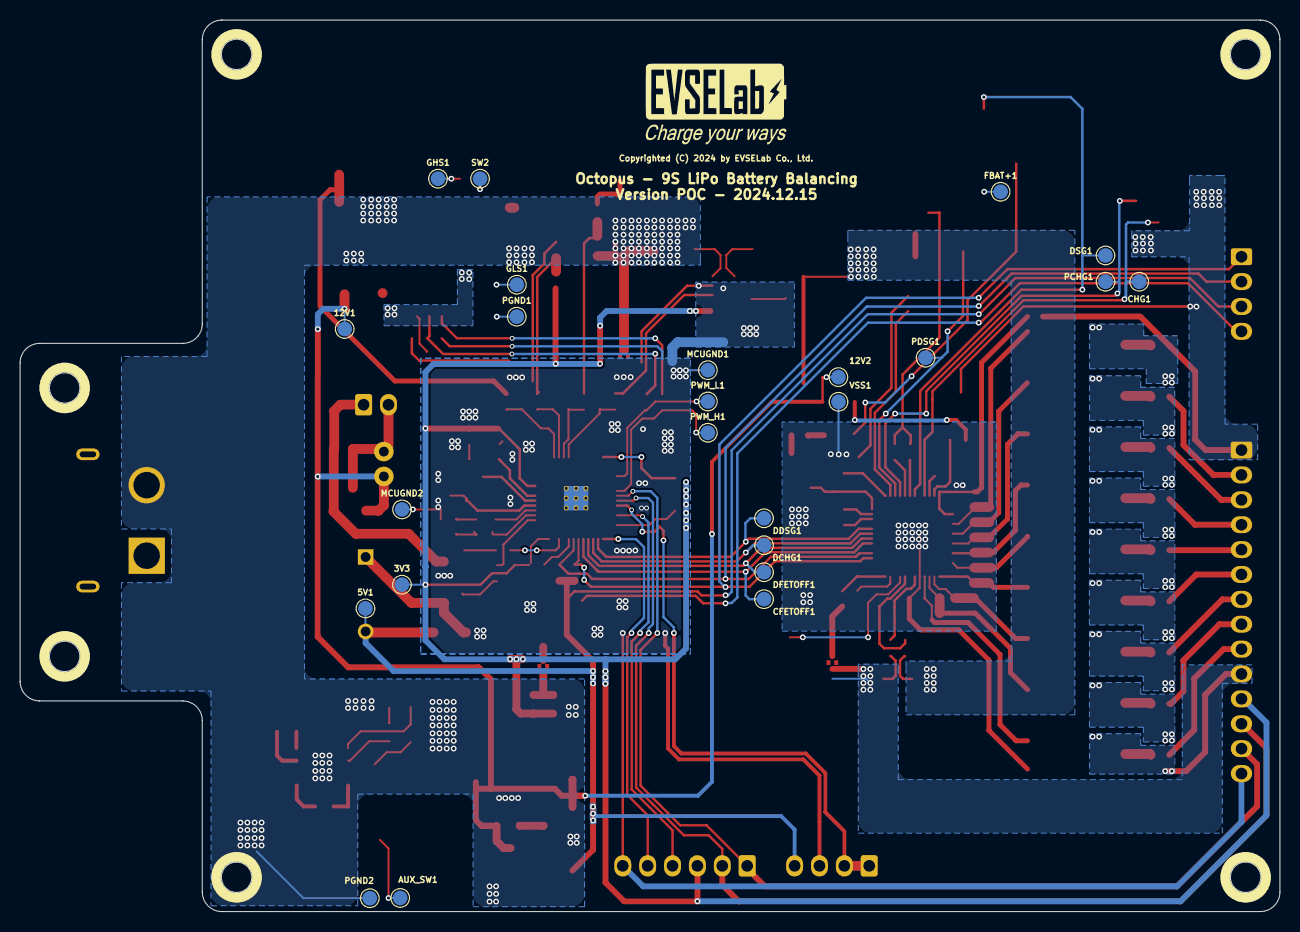
[picture p6: board v241218_Octopus_VerA1.kicad_pcb from below]

Board: 2 copper layers, 128.6 x 91.0 mm, 260 parts (24 on the bottom side), 133 nets.
