dinhnd-hust/Octopus/(notices)

Notices in the files:
v241218_Octopus_VerA1.kicad_pcb:
Copyrighted (C) 2024 by EVSELab Co., Ltd.
